lab11/slocalization/README.md

# slocalization
High-Fidelity Localization of Slow Energy-Harvesting Tags
