lab11/slocalization/pcb/slotag/slotag_v0p1/slotag_v0p1.kicad_pcb

## KiCad design pcb/slotag/slotag_v0p1/slotag_v0p1.kicad_pcb (2016-02-21)

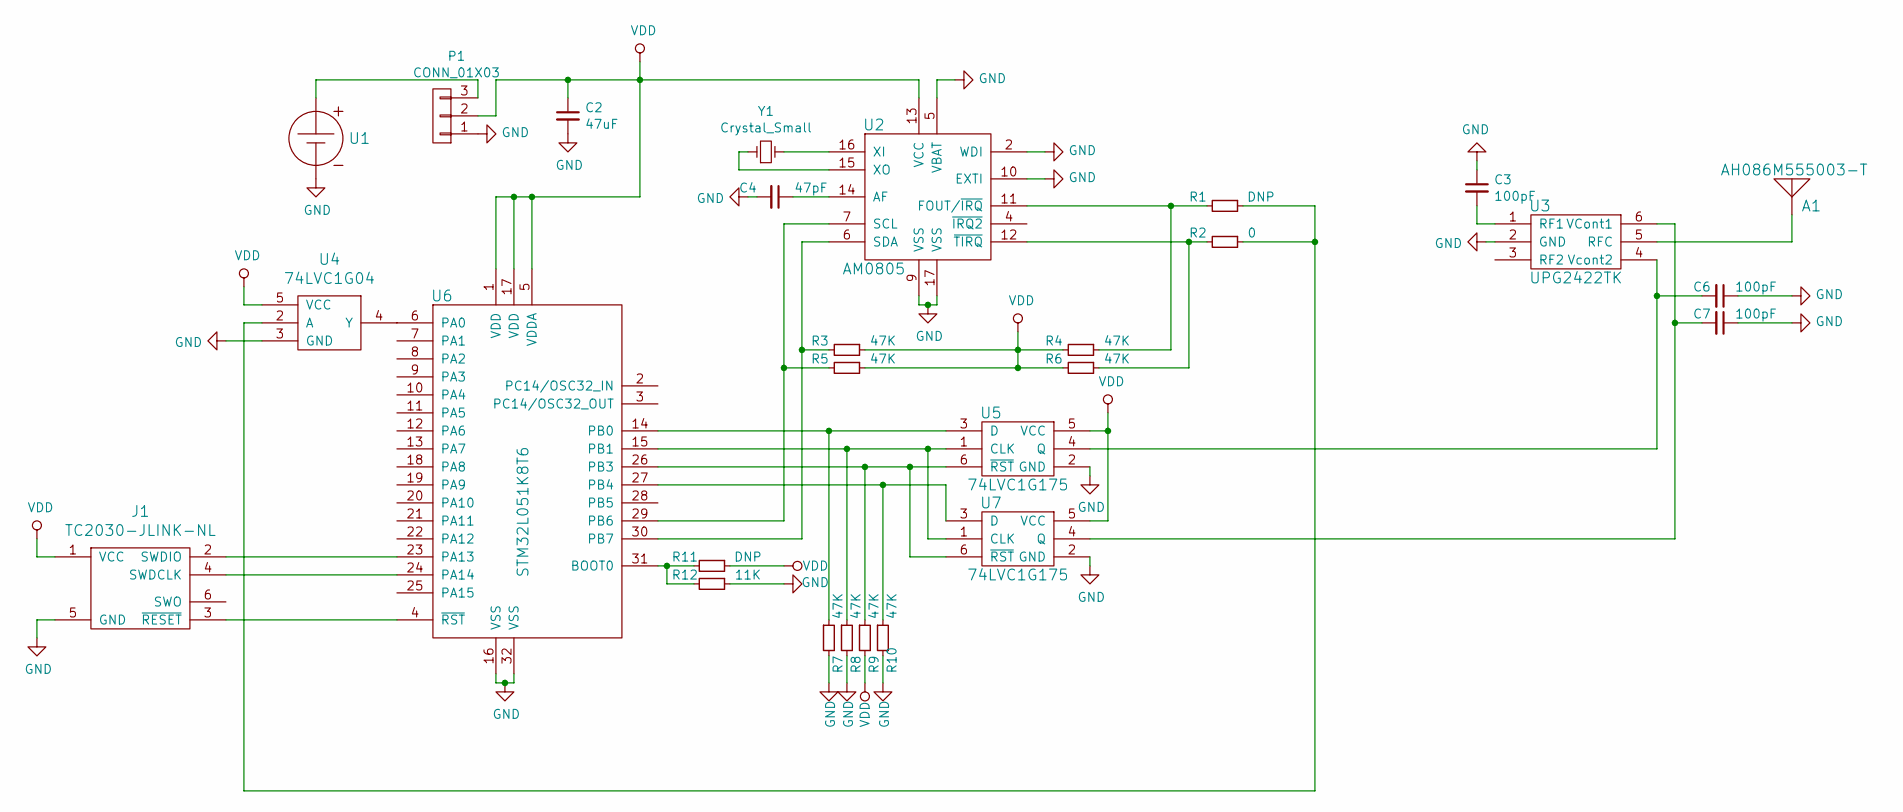
[picture p1: schematic slotag_v0p1.sch]

Parts:
A1: ANT; AH086M; ManPartNo AH086M555003-T
C2: 47uF; C_0805; ManPartNo TLNN476M010R6000
C3, C6, C7: 100pF; C_0402; ManPartNo GRM1555C1H101JA01J
C4: 47pF; C_0402; ManPartNo GRM1555C1H470JA01D
J1: TC2030-JLINK-NL; TC2030
P1: CONN_01X03; Pin_Header_Straight_1x03
R1, R11: DNP; R_0402
R2: 0; R_0402; ManPartNo ERJ-2GE0R00X
R3, R4, R5, R6, R7, R8, R9, R10: 47K; R_0402; ManPartNo ERJ-2RKF4702X
R12: 11K; R_0402; ManPartNo ERJ-2RKF1102X
U1: SOLAR_CELL; AM-1417; ManPartNo AM-1417CA
U2: AM0805; QFN-16-1EP_3x3mm_Pitch0.5mm
U3: UPG2422TK; MINIMOLD-6; ManPartNo UPG2422TK-A
U4: 74LVC1G04; SOT-353; ManPartNo 74LVC1G04GW,125
U5, U7: 74LVC1G175; SOT-363; ManPartNo 74LVC1G175GW,125
U6: STM32L051K8T6; LQFP-32_7x7mm_Pitch0.8mm; ManPartNo STM32L051K8T6
Y1: Crystal_Small; XTAL-3.2mm-1.5mm; ManPartNo ABS07-32.768KHZ-7-T

Connections:
GND: C2.2, C3.1, C4.2, C6.1, C7.1, J1.5 (GND), P1.1, R7.2, R8.2, R10.2, R12.1, U1.2, U2.2 (WDI), U2.5 (VBAT), U2.9 (VSS), U2.10 (EXTI), U2.17 (VSS), U3.2 (GND), U4.3 (GND), U5.2 (GND), U6.16 (VSS), U6.32 (VSS), U7.2 (GND)
unnamed: A1.1, U3.5 (RFC)
unnamed: C3.2, U3.1 (RF1)
unnamed: C4.1, U2.14 (AF)
unnamed: C6.2, U3.4 (Vcont2), U5.4 (Q)
unnamed: C7.2, U3.6 (VCont1), U7.4 (Q)
unnamed: J1.2 (SWDIO), U6.23 (PA13)
unnamed: J1.3 (~RESET), U6.4 (~RST)
unnamed: J1.4 (SWDCLK), U6.24 (PA14)
unnamed: P1.3, U1.1
unnamed: R1.1, R2.1, U4.2 (A)
unnamed: R1.2, R4.1, U2.11 (FOUT/~IRQ)
unnamed: R2.2, R6.1, U2.12 (~TIRQ)
unnamed: R3.2, U2.6 (SDA), U6.30 (PB7)
unnamed: R5.2, U2.7 (SCL), U6.29 (PB6)
unnamed: R7.1, U5.3 (D), U6.14 (PB0)
unnamed: R8.1, U5.1 (CLK), U6.15 (PB1), U7.1 (CLK)
unnamed: R9.1, U5.6 (~RST), U6.26 (PB3), U7.6 (~RST)
unnamed: R10.1, U6.27 (PB4), U7.3 (D)
unnamed: R11.2, R12.2, U6.31 (BOOT0)
unnamed: U2.15 (XO), Y1.1
unnamed: U2.16 (XI), Y1.2
unnamed: U4.4 (Y), U6.6 (PA0)
VDD: C2.1, J1.1 (VCC), P1.2, R3.1, R4.2, R5.1, R6.2, R9.2, R11.1, U2.13 (VCC), U4.5 (VCC), U5.5 (VCC), U6.1 (VDD), U6.5 (VDDA), U6.17 (VDD), U7.5 (VCC)

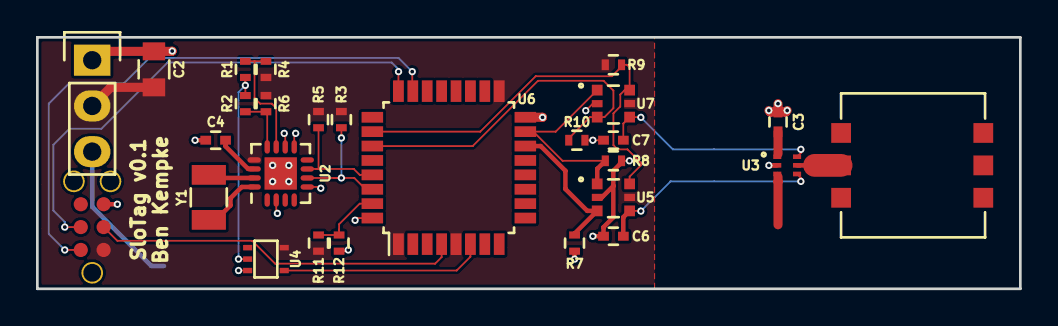
[picture p2: board slotag_v0p1.kicad_pcb from above]

Board: 2 copper layers, 54.6 x 14.0 mm, 28 parts (1 on the bottom side), 24 nets.
