lab11/slocalization/(commit log)

2016-02-20 adding first pass at 2-layer slocalization tag
    [slotag_v0p1.kicad_pcb, slotag_v0p1.sch]
2016-02-21 adding component part numbers
    [slotag_v0p1.sch]
2016-02-21 minor cosmetic fixes
    [slotag_v0p1.kicad_pcb, slotag_v0p1.sch]
2016-02-21 adding gerbers for slotag
    [slotag_v0p1-B.Cu.gbr, slotag_v0p1-B.Mask.gbr, slotag_v0p1-B.SilkS.gbr, slotag_v0p1-Edge.Cuts.gbr, slotag_v0p1-F.Cu.gbr, slotag_v0p1-F.Mask.gbr, slotag_v0p1-F.SilkS.gbr, slotag_v0p1.drl]
2016-02-22 adding slotag BOM
    [slotag_v0p1.csv]
2016-02-29 major progress: able to configure Ambiq RTC over I2C to produce square wave on FOUT pin
2016-03-01 Ambiq RTC now triggers periodic (1 Hz) wakeup events. Need to work on reducing average power consumption
2016-03-01 1 Hz PN code sequencing now works
2016-03-02 Turn on link-time-optimization
    This lets gcc treat all of the objects as one giant program and do
    optimization over the whole thing. Gets big wins for stuff like
    register writes because inlining can occur much more aggressively.
    Halves the code size of the current project and shaves ~350 us off
    the startup time.
2016-03-02 Pull more efficient startup assembly from submodule
2016-03-02 Kill of `HAL_Init`, doesn't seem to matter
    [main.c]
2016-03-02 Move I2CxHandle out of global memory
    This is a bit a trick, since it needs to be global but is only used
    in the cold boot case. What we do then is make a global pointer to
    the structure and then zero-init and fill a copy only on the cold
    boot path where it's used.
    This trade-off makes the 1-time true cold boot a little bit slower
    but the long-running warm-boot faster [also trades off a little
    code space]
    the structure in the cold-boot
2016-03-02 Skip tradtional reset handler
    [main.c]
2016-03-07 Update slotag_v0p1.csv
    Fix commas so that github doesn't yell about invalid csv
    [slotag_v0p1.csv]
2016-03-22 modifications to support antenna diversity
2017-03-29 adding modifications to SBX driver
